voltnik/RGB-flashlight/RGB-flashlight_bb1.jpg

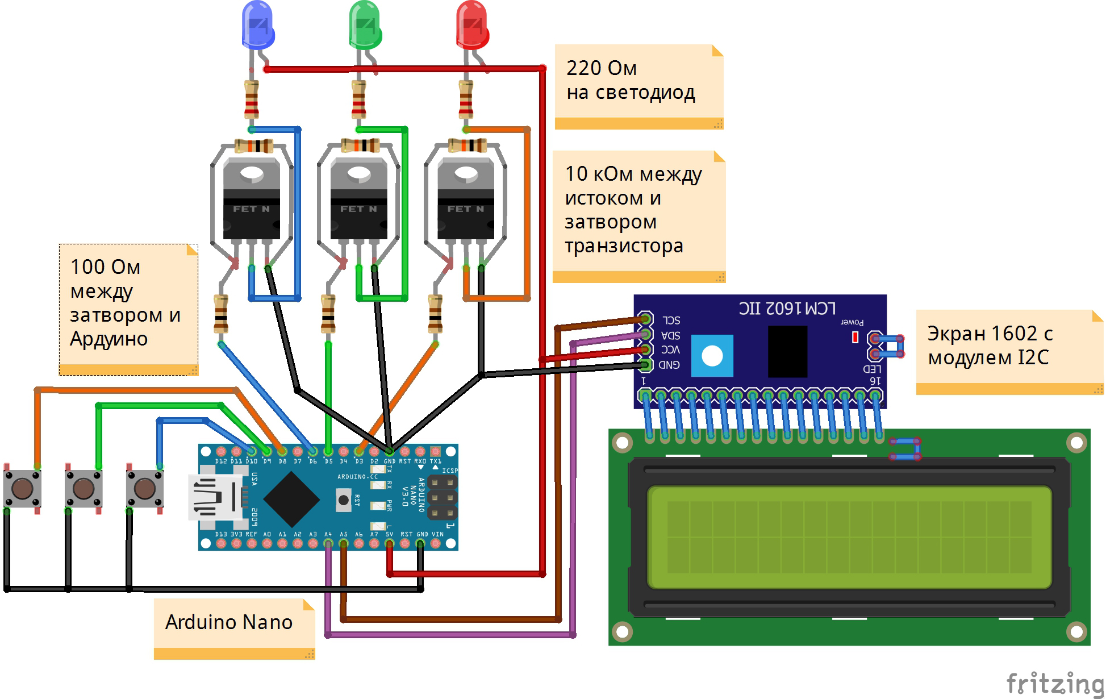
RGB-flashlight_bb1.jpg
