voltnik/RGB-flashlight/shablon/RBG-front.pdf

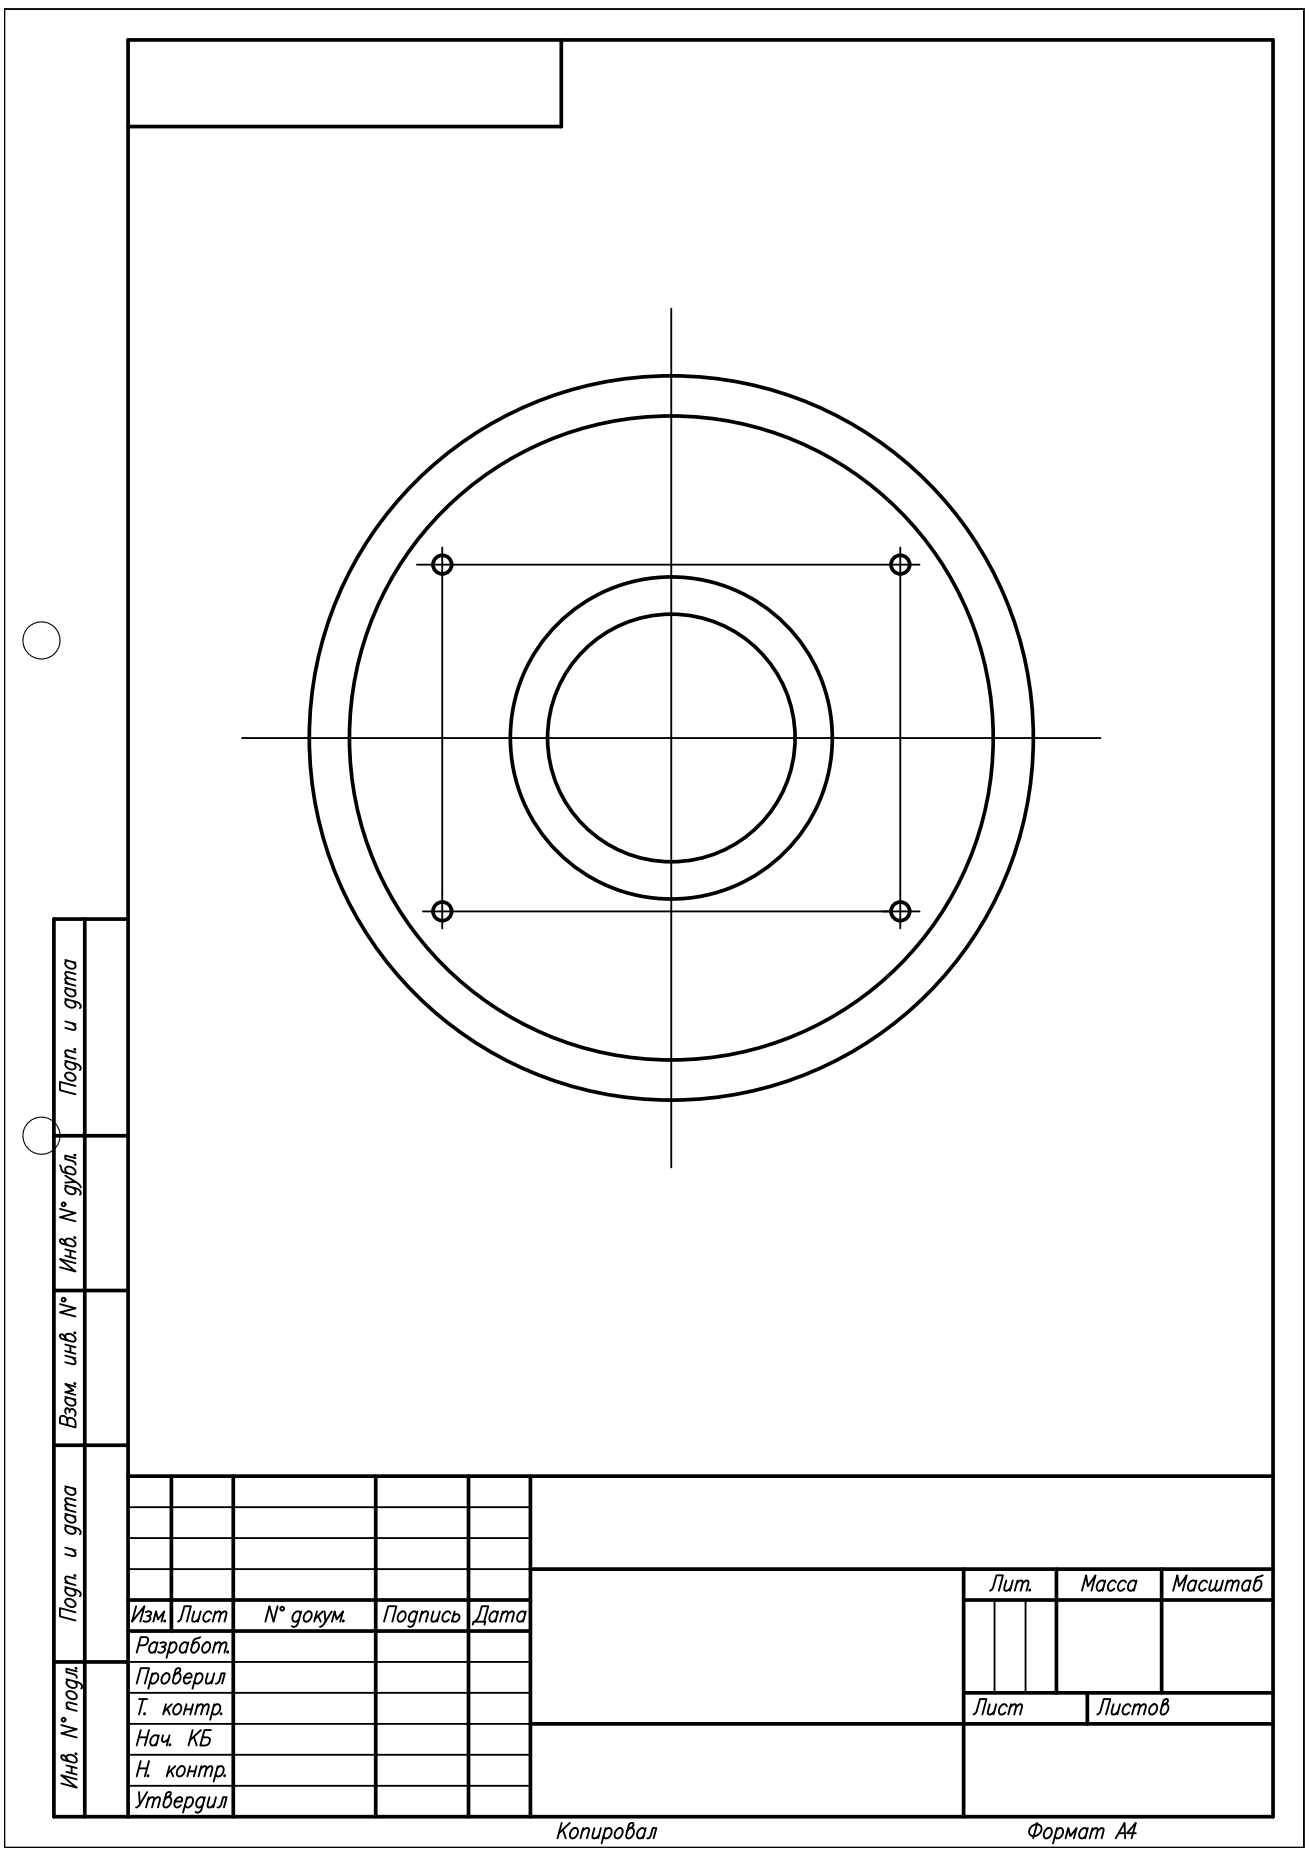
[picture p4: page 1]
