voltnik/RGB-flashlight/shablon/RGB-back.pdf

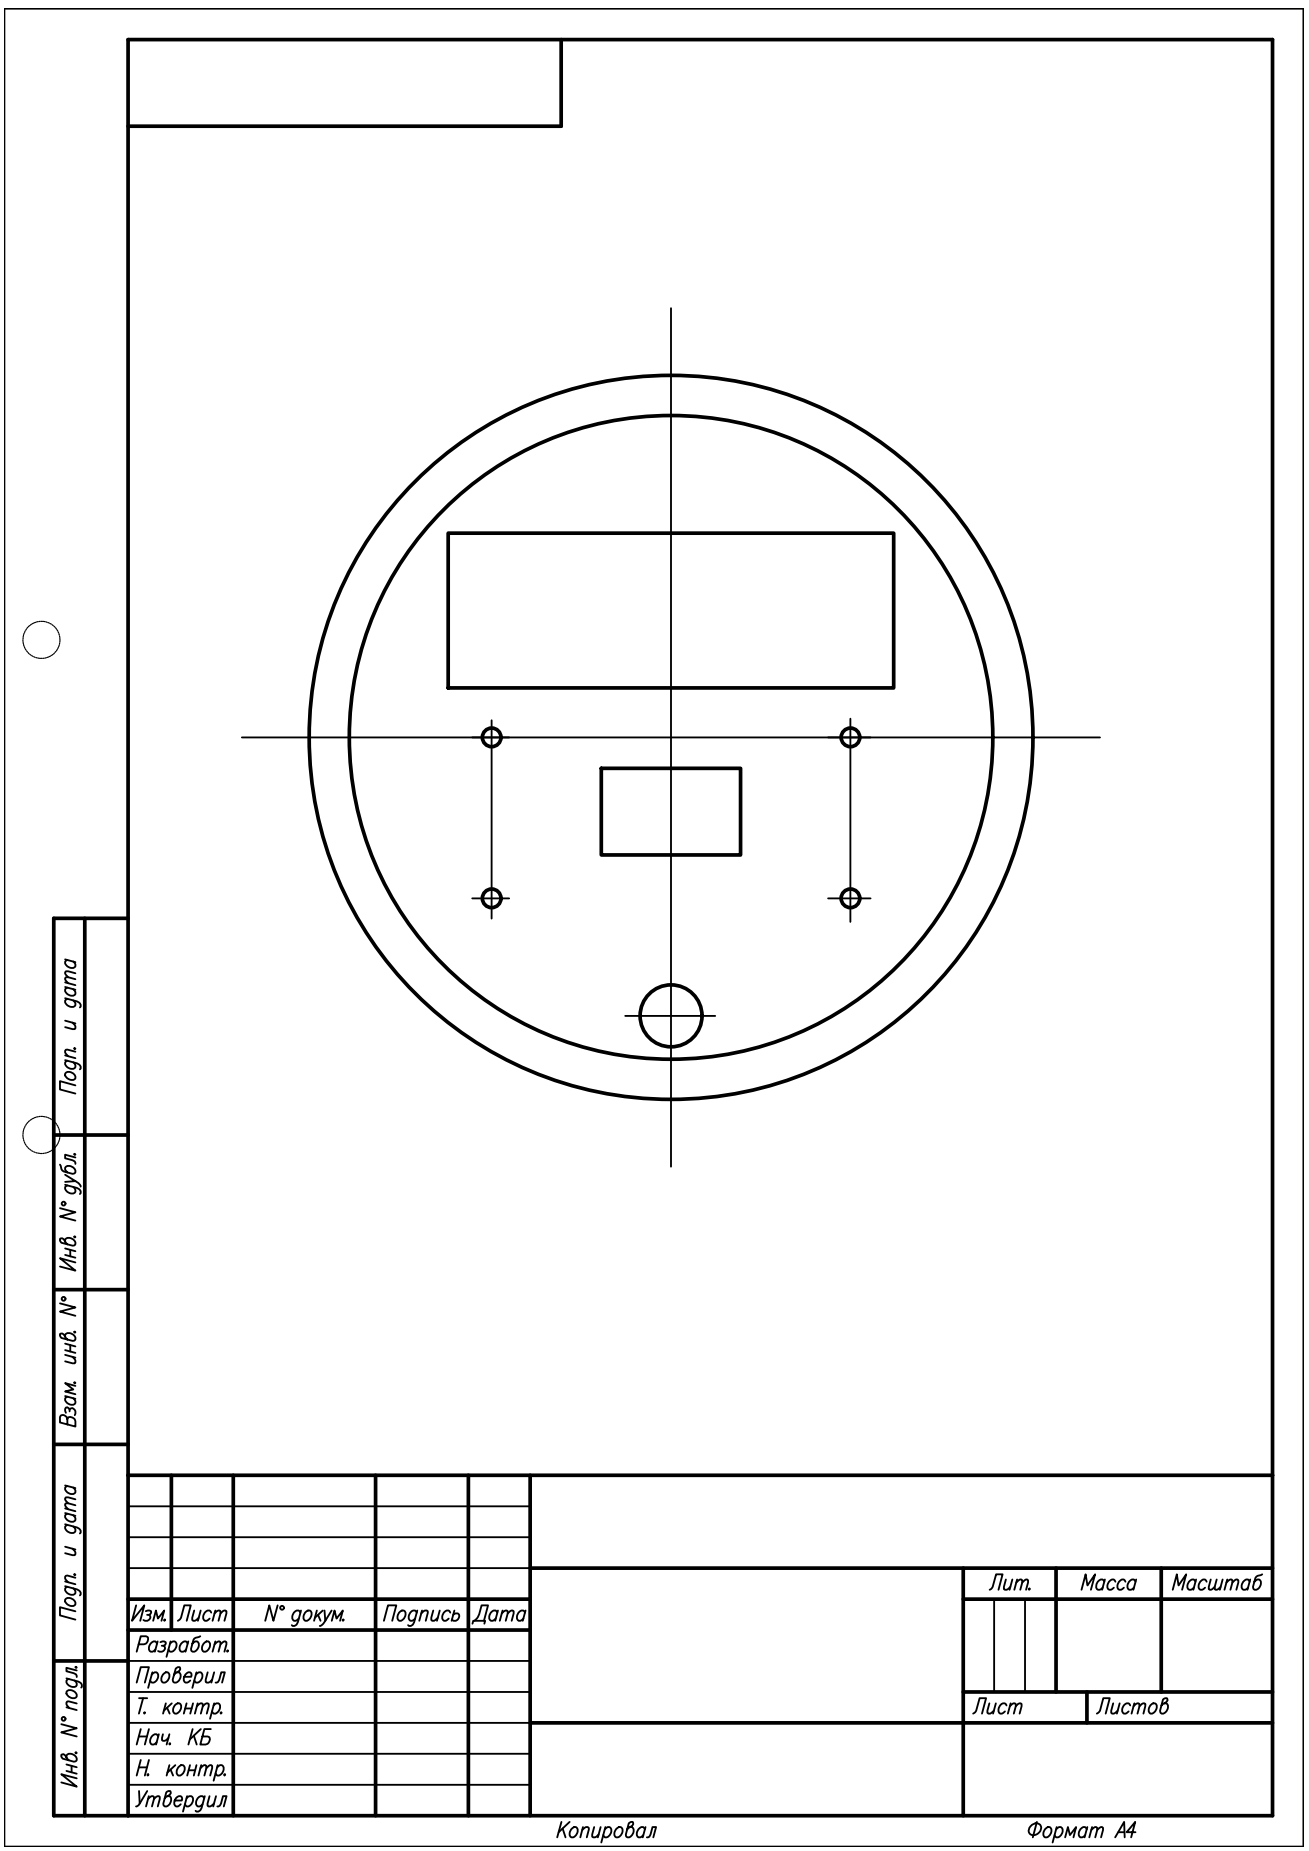
[picture p5: page 1]
